siyad23/LFR/Circuit Design/PCBDesign/ReferenceFiles/H-Bridge-Motor-Driver-Circuit-L293D.png

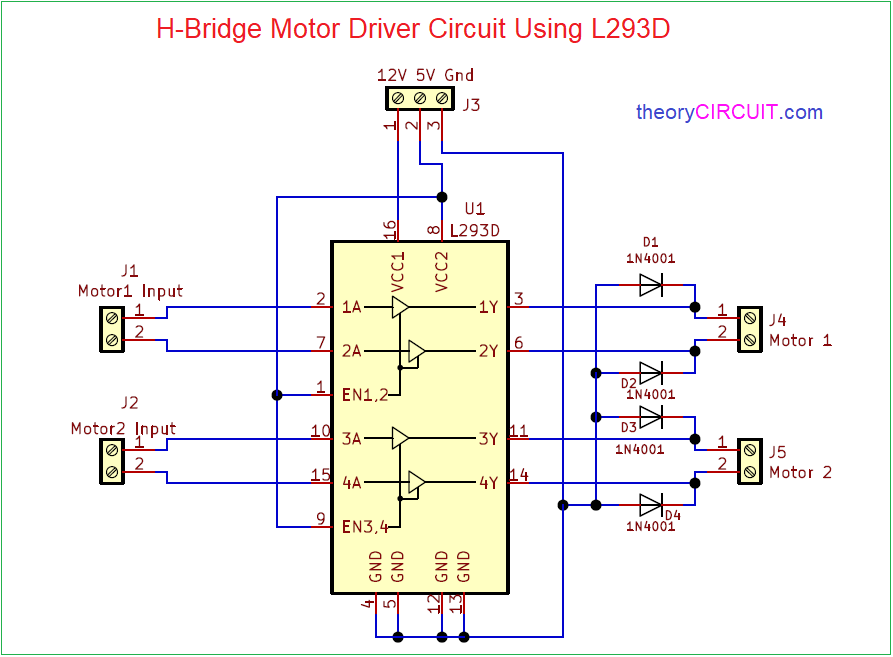
Circuit Design/PCBDesign/ReferenceFiles/H-Bridge-Motor-Driver-Circuit-L293D.png
