siyad23/LFR/MechanicalDesign/Enclosure/EnclosureDraft.JPG

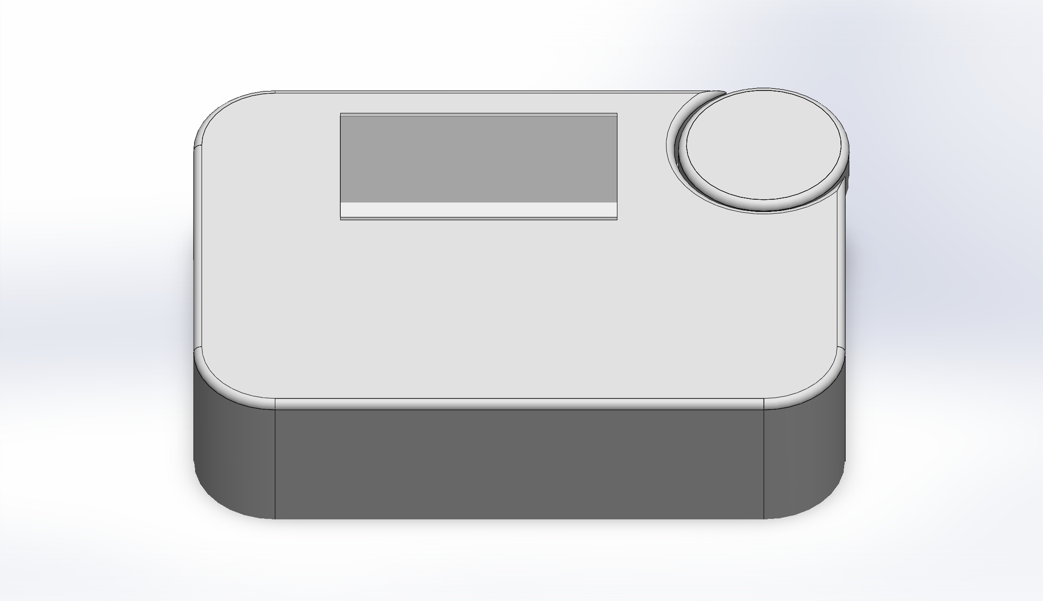
MechanicalDesign/Enclosure/EnclosureDraft.JPG
