siyad23/LFR/MechanicalDesign/mainBody.SLDPRT

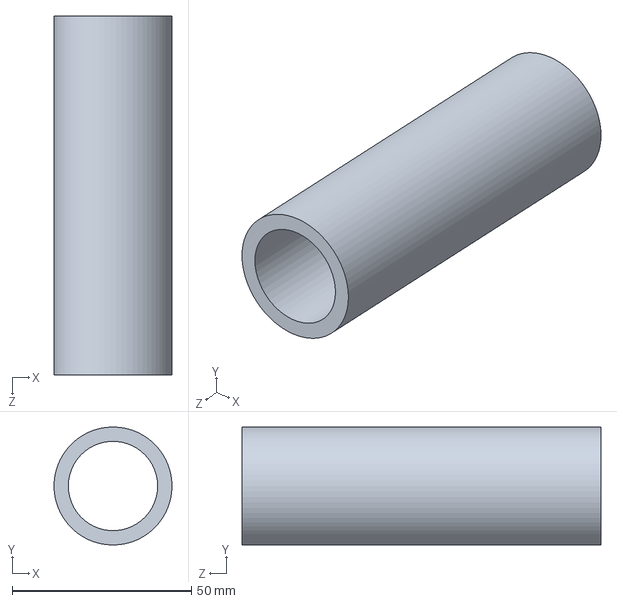
[picture p4: CAD file, 2025-07-23]
MechanicalDesign/mainBody.SLDPRT
32.9 x 32.9 x 100.0 mm
