siyad23/LFR/Chassis Design/Step Files/Sonar setup.STEP

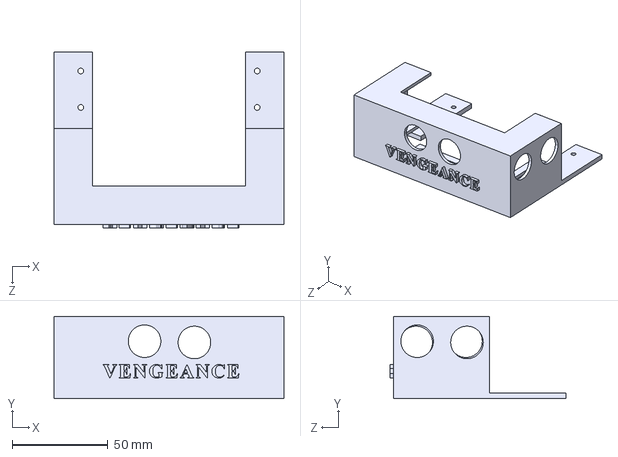
[picture p5: CAD file, 2025-07-26]
Chassis Design/Step Files/Sonar setup.STEP
120.0 x 43.0 x 92.0 mm
