siyad23/LFR/MechanicalDesign/Enclosure/EnclosureDraft.SLDPRT

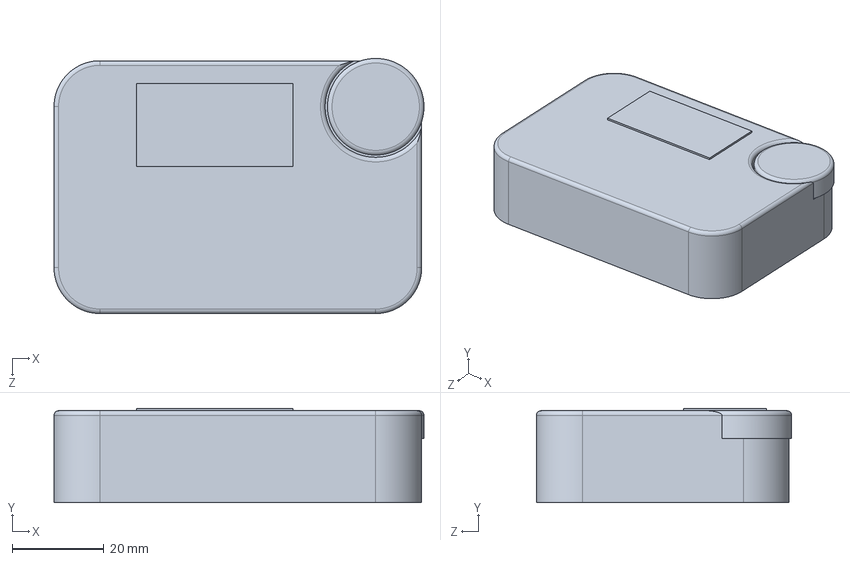
[picture p6: CAD file, 2025-07-05]
MechanicalDesign/Enclosure/EnclosureDraft.SLDPRT
80.5 x 20.5 x 55.5 mm
