siyad23/LFR/Chassis Design/Step Files/Motor Hub.STEP

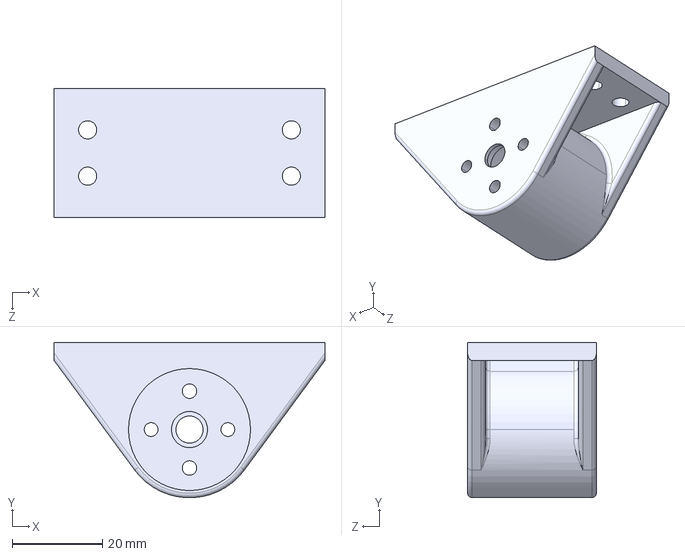
[picture p7: CAD file, 2025-07-26]
Chassis Design/Step Files/Motor Hub.STEP
60.0 x 34.4 x 28.5 mm
