siyad23/LFR/MechanicalDesign/Motor.SLDPRT

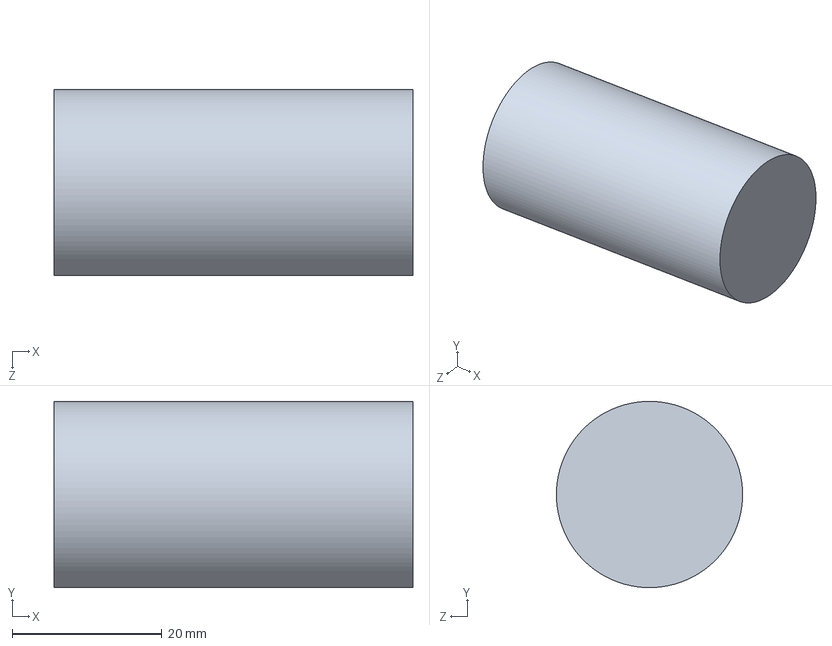
[picture p8: CAD file, 2025-07-23]
MechanicalDesign/Motor.SLDPRT
48.0 x 24.9 x 24.9 mm
