siyad23/LFR/Chassis Design/Step Files/LFR Body.STEP

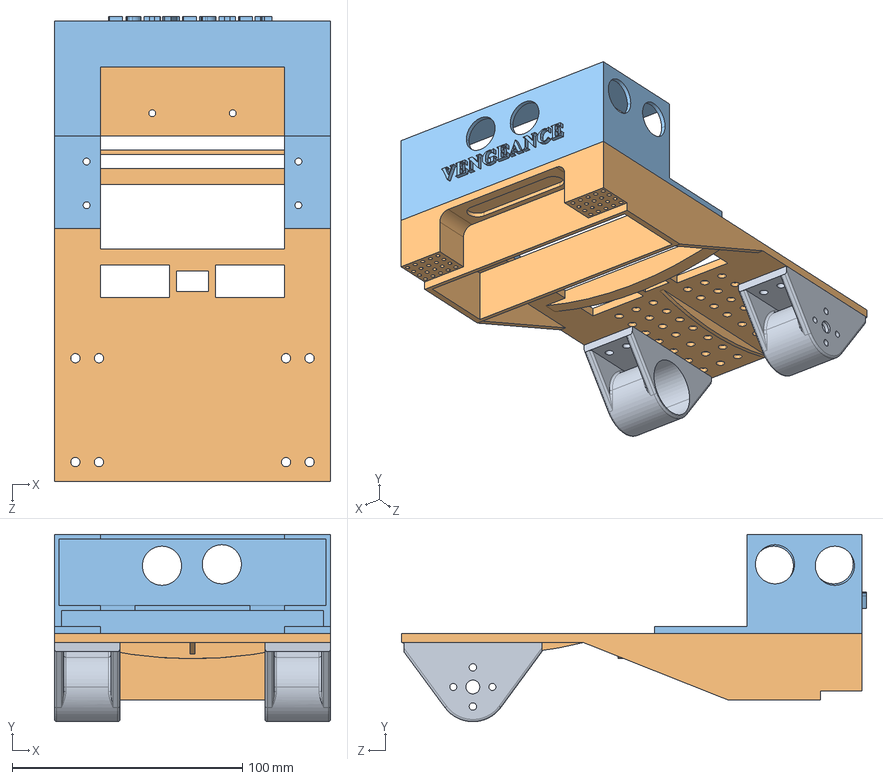
[picture p9: CAD file, 2025-07-26]
Chassis Design/Step Files/LFR Body.STEP
120.0 x 81.4 x 202.0 mm
Motor Hub x 2
Chassis
Sonar setup
