siyad23/LFR/Chassis Design/Step Files/Chassis.STEP

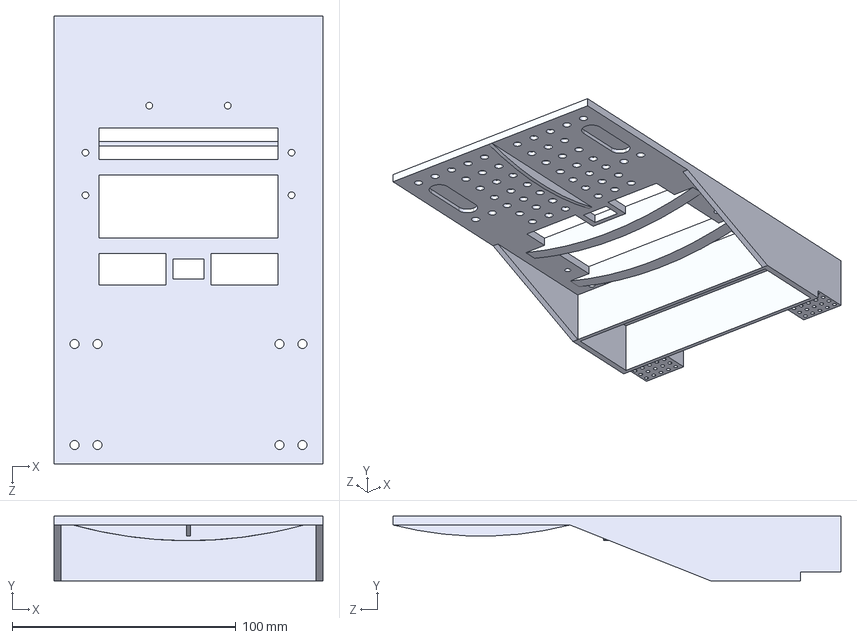
[picture p10: CAD file, 2025-07-26]
Chassis Design/Step Files/Chassis.STEP
120.0 x 29.0 x 200.0 mm
