siyad23/LFR/(list of files, cad)

Other CAD files:
Chassis Design/STL Files/LFR Body - Sonar setup.STL
Chassis Design/SolidWorks Files/Chassis.SLDPRT
Chassis Design/SolidWorks Files/LFR Body.SLDASM
Chassis Design/SolidWorks Files/Motor Hub.SLDPRT
Chassis Design/SolidWorks Files/Sonar setup.SLDPRT
