siyad23/LFR/Circuit Design/VeroBoard Design/print.pdf

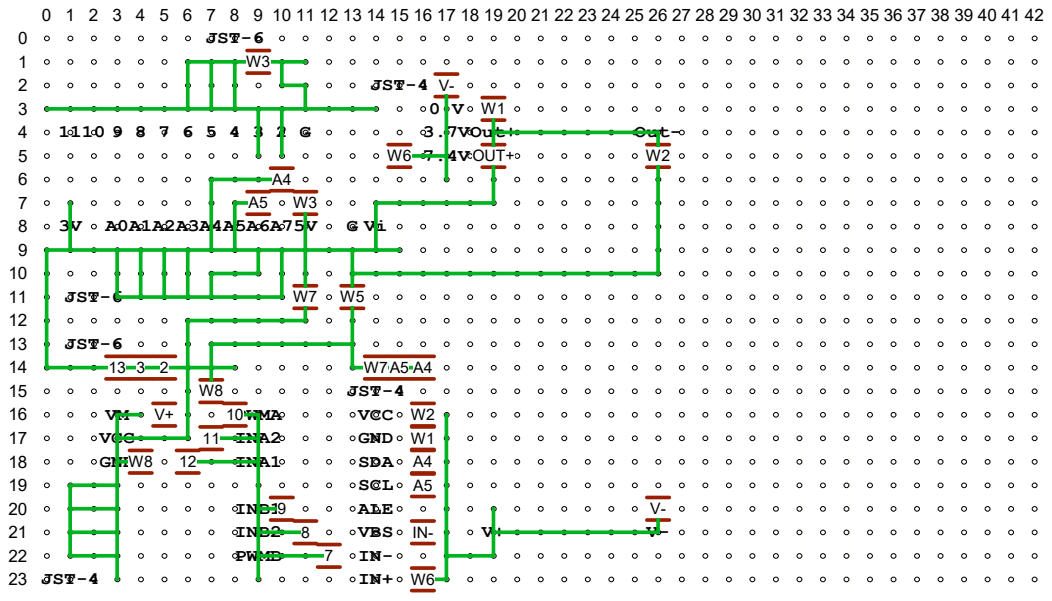
[picture p13: page 1]
GND; JST-4; VCC; JST-6; INA2; PWMA; INA1; INB1 INB2 PWMB; Out+; Out-; VCC GND SDA SCL ALE VBS IN- IN+; OUT+

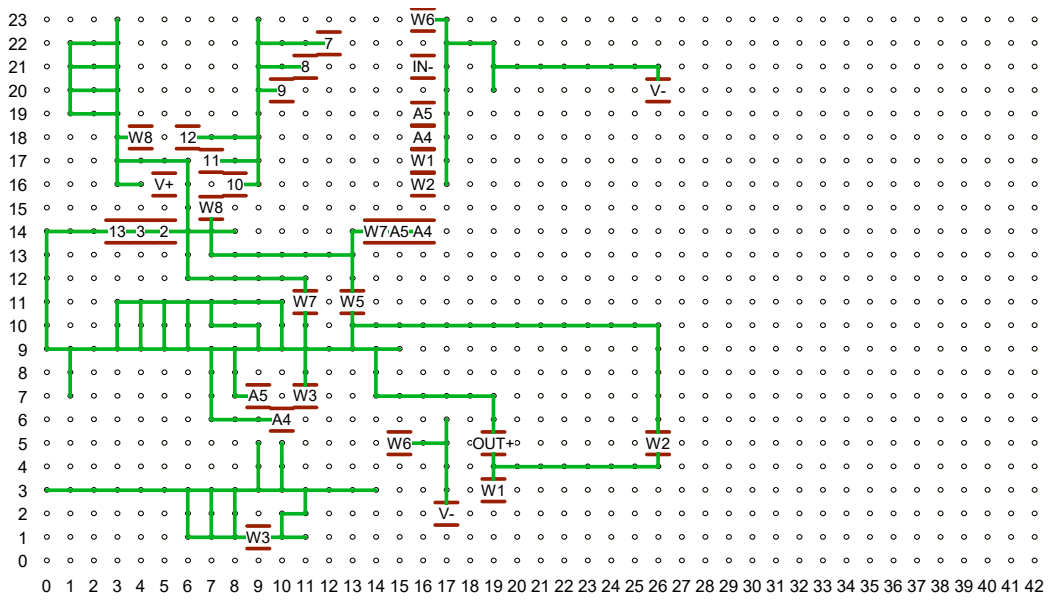
[picture p14: page 2]
OUT+
