siyad23/LFR/Circuit Design/VeroBoard Design/RearView.pdf

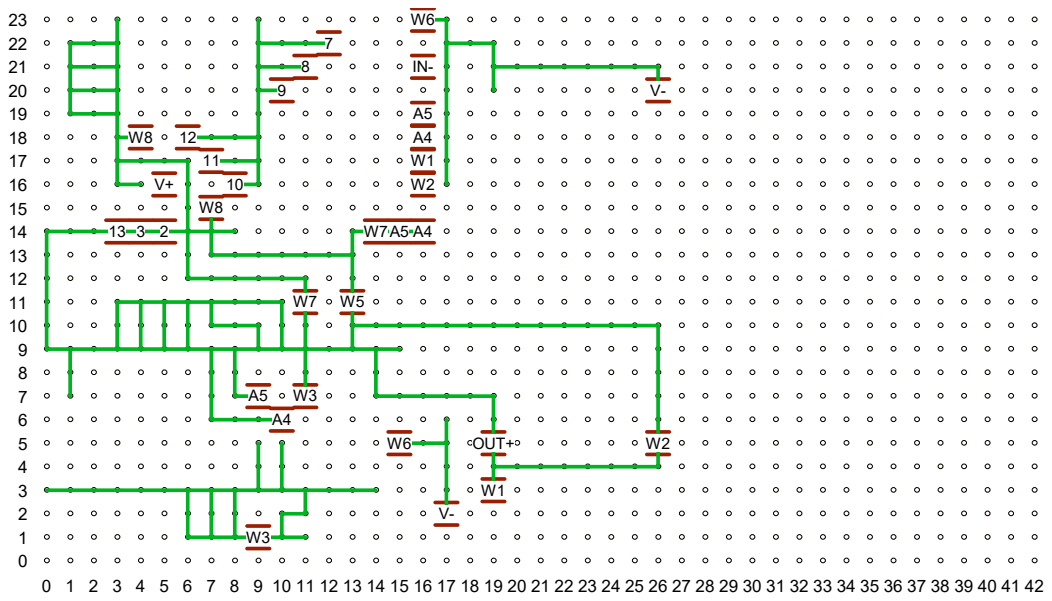
[picture p15: page 1]
OUT+

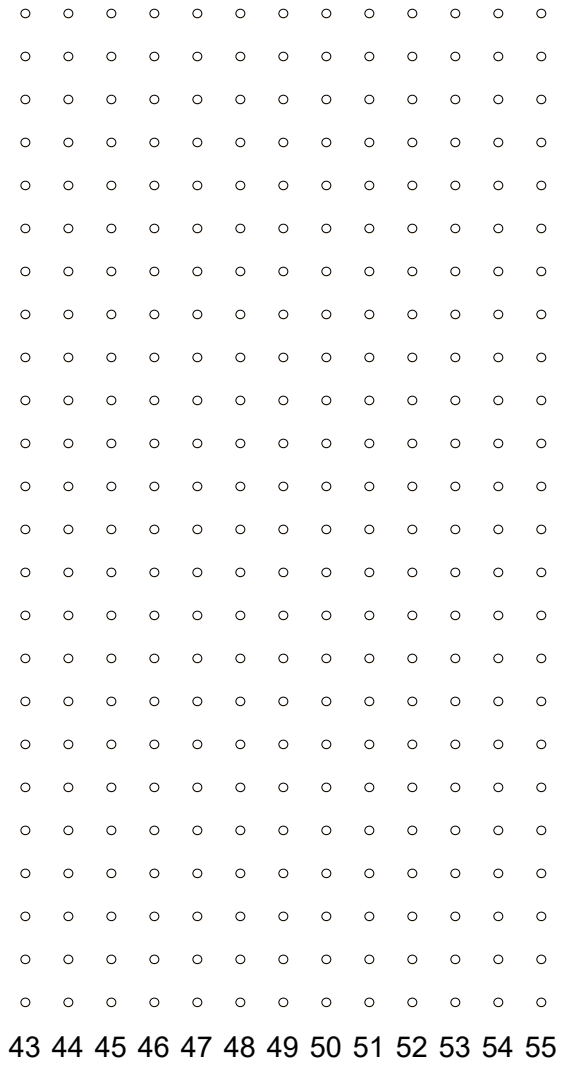
[picture p16: page 2]
