siyad23/LFR/Circuit Design/PCBDesign/LFRCircuit/LFR_Circuit_PDF/LFRCircuit-B_Cu.pdf

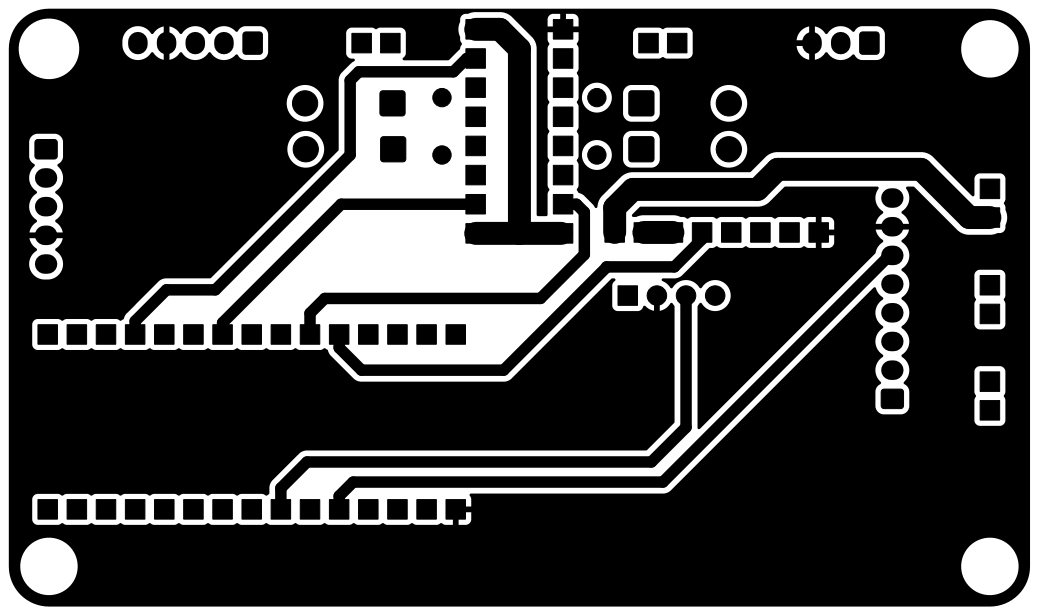
[picture p17: page 1]
