siyad23/LFR/Circuit Design/PCBDesign/LFRCircuit/LFR_Circuit_PDF/LFRCircuit-B_Mask.pdf

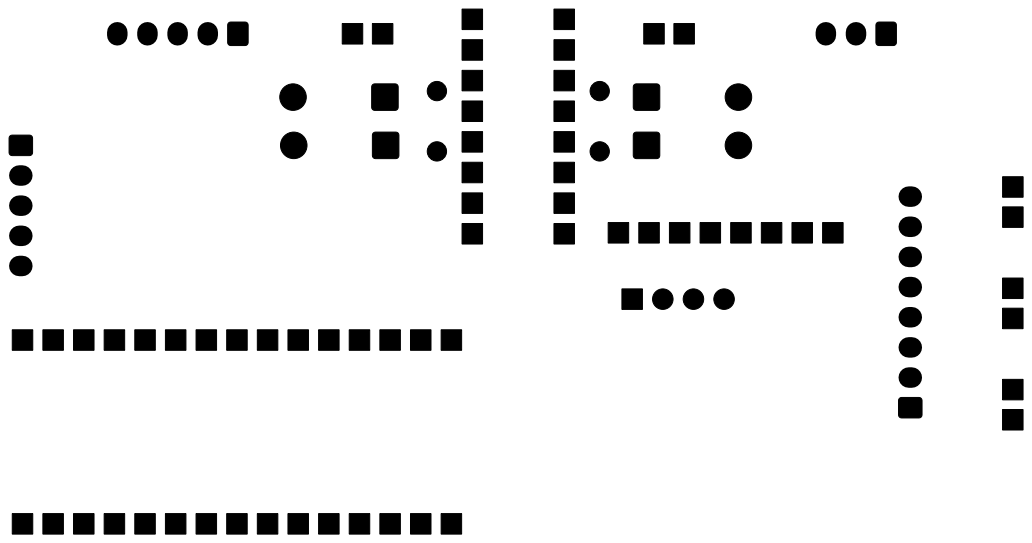
[picture p18: page 1]
