siyad23/LFR/Circuit Design/PCBDesign/LFRCircuit/LFR_Circuit_PDF/LFRCircuit-Edge_Cuts.pdf

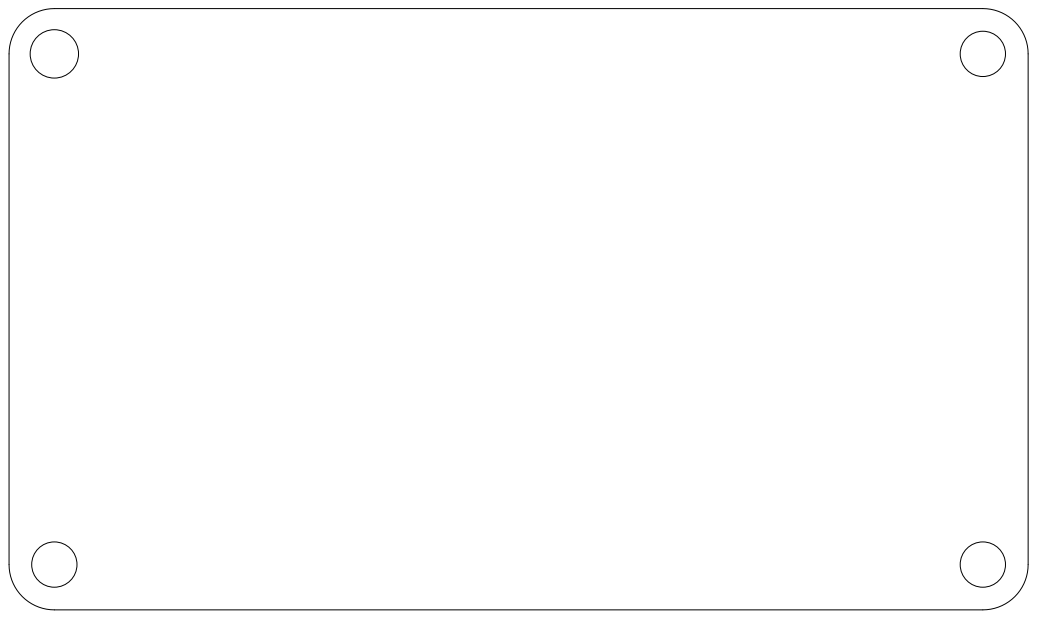
[picture p19: page 1]
