siyad23/LFR/Circuit Design/PCBDesign/LFRCircuit/LFR_Circuit_PDF/LFRCircuit-F_Cu.pdf

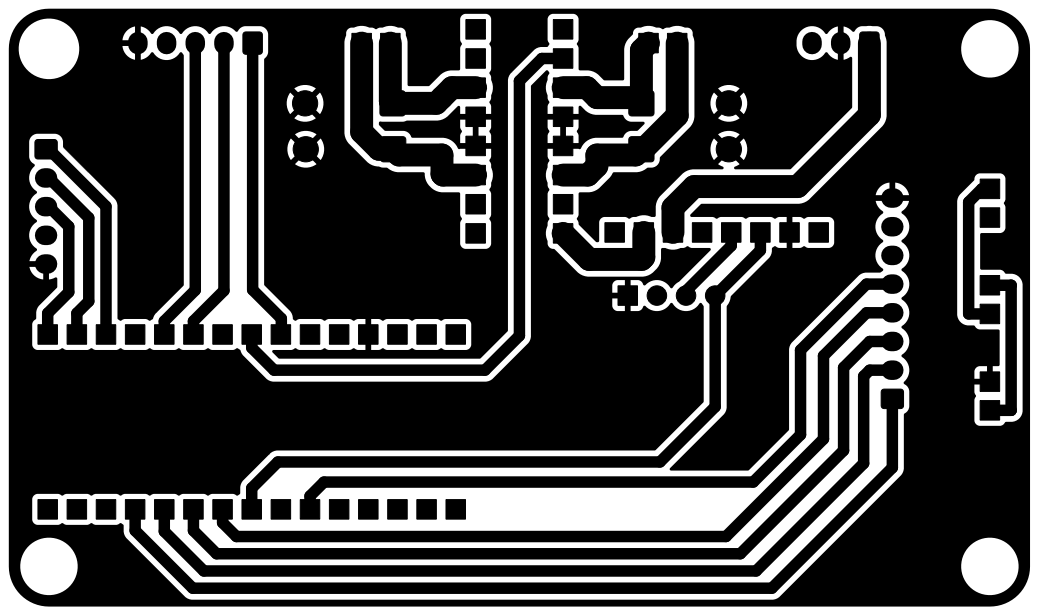
[picture p20: page 1]
