siyad23/LFR/Circuit Design/PCBDesign/LFRCircuit/LFR_Circuit_PDF/LFRCircuit-F_Silkscreen.pdf

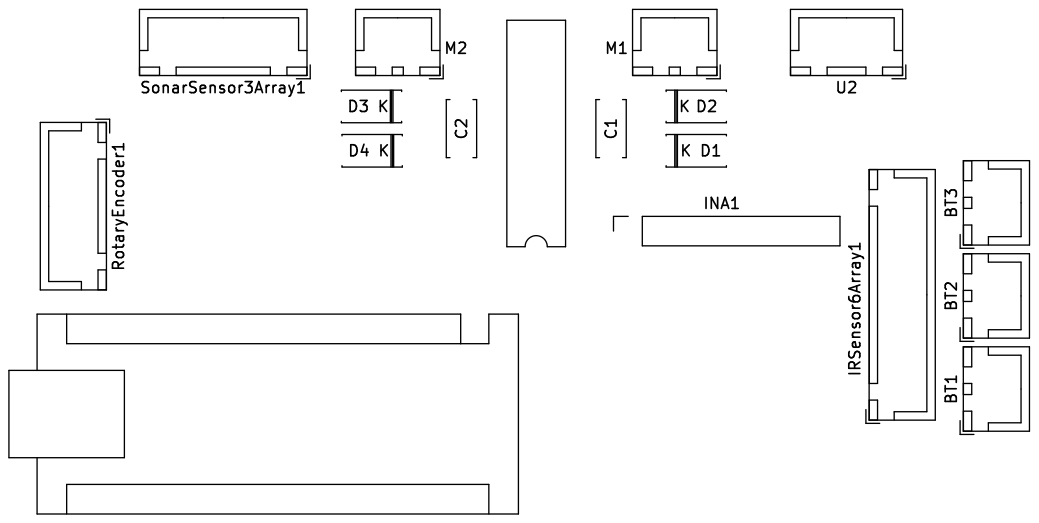
[picture p21: page 1]
