siyad23/LFR/Circuit Design/PCBDesign/LFRCircuit/LFRCircuit.kicad_pcb

## KiCad design Circuit Design/PCBDesign/LFRCircuit/LFRCircuit.kicad_pcb (2025-07-26)

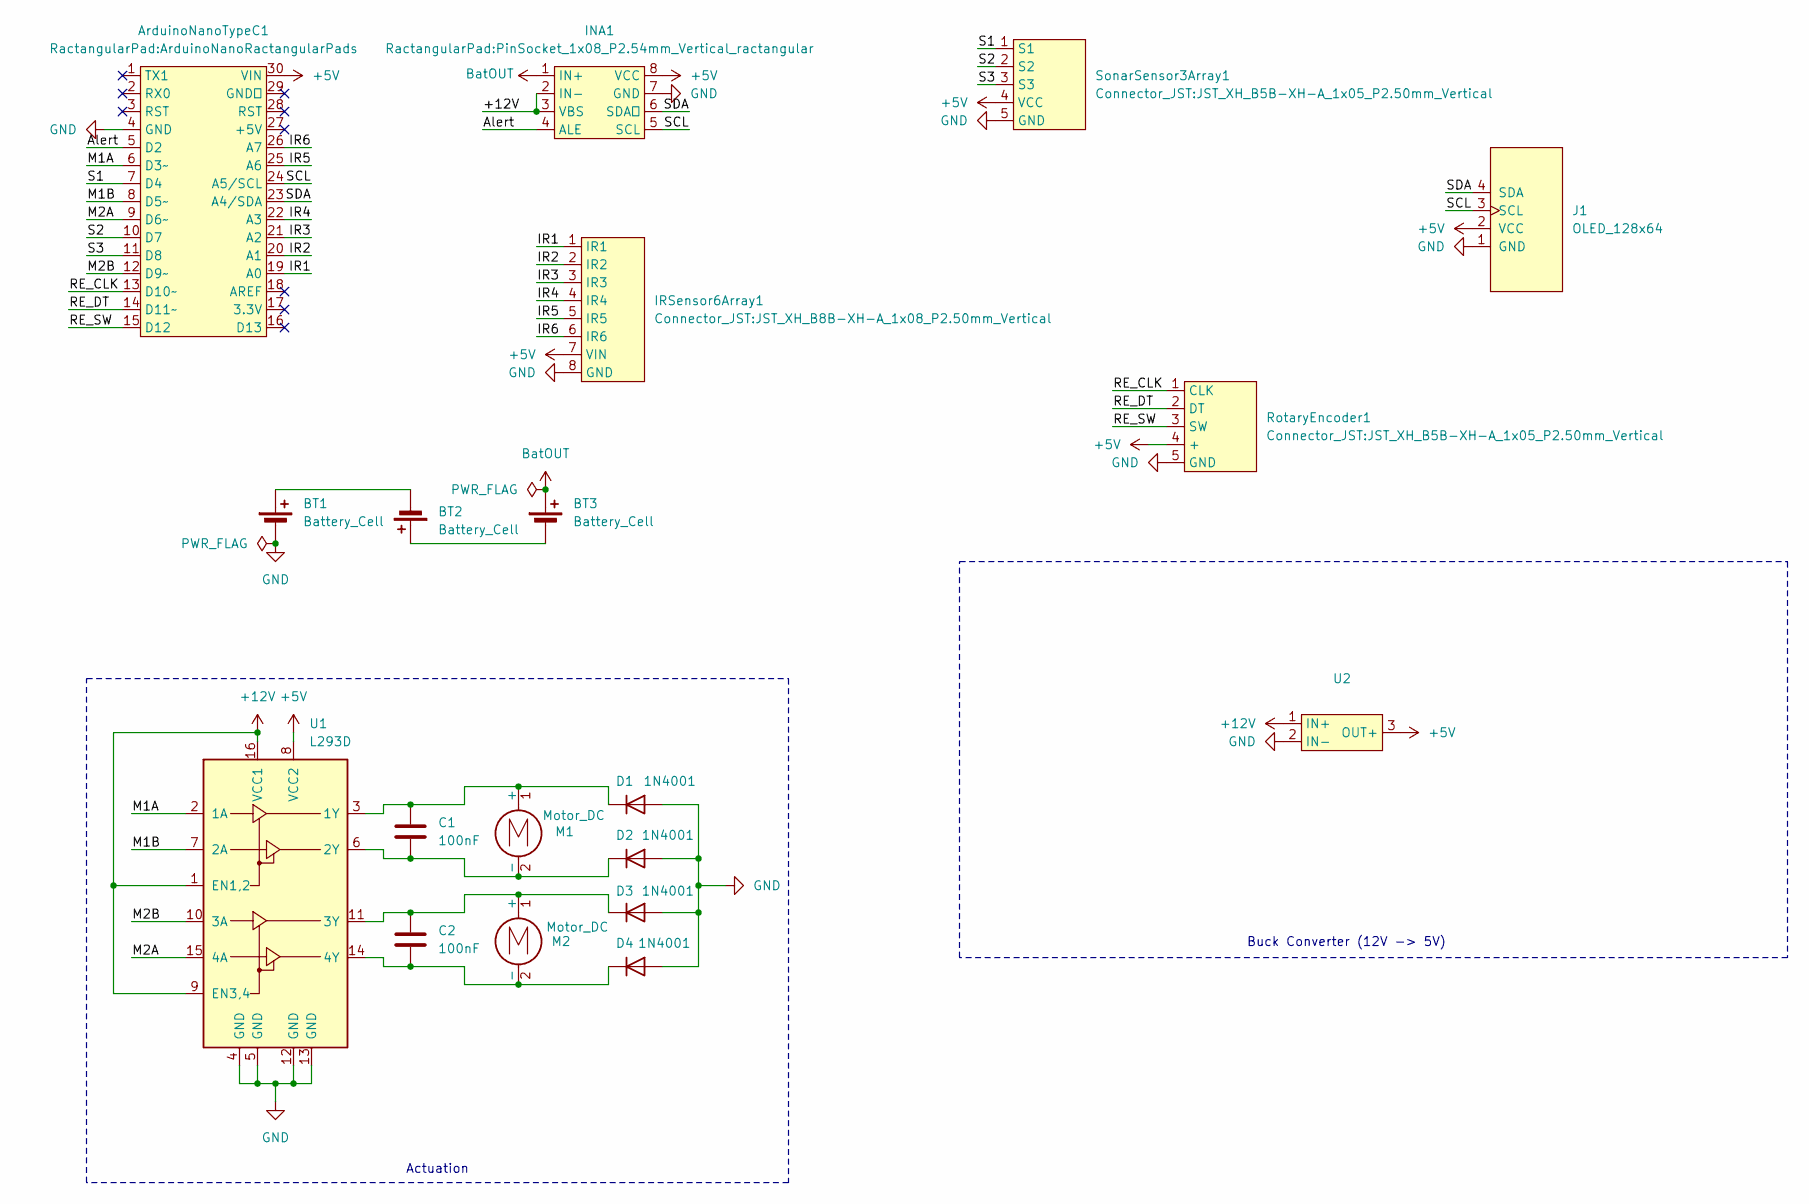
[picture p22: schematic LFRCircuit.kicad_sch, LFR_PCB]

Parts:
ArduinoNanoTypeC1: ArduinoNanoRactangularPads
BT1, BT2, BT3: Battery_Cell; JST_XH_B2B-XH-A_1x02_P2.50mm_Vertical_ractangular
C1, C2: 100nF; C_Disc_D5.0mm_W2.5mm_P5.00mm
D1, D2, D3, D4: 1N4001; D_DO-41_SOD81_P7.62mm_Horizontal
INA1: PinSocket_1x08_P2.54mm_Vertical_ractangular
IRSensor6Array1: JST_XH_B8B-XH-A_1x08_P2.50mm_Vertical
J1: OLED_128x64
M1, M2: Motor_DC; JST_XH_B2B-XH-A_1x02_P2.50mm_Vertical_ractangular
RotaryEncoder1: JST_XH_B5B-XH-A_1x05_P2.50mm_Vertical
SonarSensor3Array1: JST_XH_B5B-XH-A_1x05_P2.50mm_Vertical
U1: L293D; DIP-16_W7.62mm_ractangularPads
U2: JST_XH_B3B-XH-A_1x03_P2.50mm_Vertical

Connections:
+5V: ArduinoNanoTypeC1.30 (VIN), INA1.8 (VCC), IRSensor6Array1.7 (VIN), J1.2 (VCC), RotaryEncoder1.4 (+), SonarSensor3Array1.4 (VCC), U1.8 (VCC2), U2.3 (OUT+)
+12V: INA1.2 (IN-), INA1.3 (VBS), U1.1 (EN1,2), U1.9 (EN3,4), U1.16 (VCC1), U2.1 (IN+)
/Alert: ArduinoNanoTypeC1.5 (D2), INA1.4 (ALE)
/IR1: ArduinoNanoTypeC1.19 (A0), IRSensor6Array1.1 (IR1)
/IR2: ArduinoNanoTypeC1.20 (A1), IRSensor6Array1.2 (IR2)
/IR3: ArduinoNanoTypeC1.21 (A2), IRSensor6Array1.3 (IR3)
/IR4: ArduinoNanoTypeC1.22 (A3), IRSensor6Array1.4 (IR4)
/IR5: ArduinoNanoTypeC1.25 (A6), IRSensor6Array1.5 (IR5)
/IR6: ArduinoNanoTypeC1.26 (A7), IRSensor6Array1.6 (IR6)
/M1A: ArduinoNanoTypeC1.6 (D3~), U1.2 (1A)
/M1B: ArduinoNanoTypeC1.8 (D5~), U1.7 (2A)
/M2A: ArduinoNanoTypeC1.9 (D6~), U1.15 (4A)
/M2B: ArduinoNanoTypeC1.12 (D9~), U1.10 (3A)
/RE_CLK: ArduinoNanoTypeC1.13 (D10~), RotaryEncoder1.1 (CLK)
/RE_DT: ArduinoNanoTypeC1.14 (D11~), RotaryEncoder1.2 (DT)
/RE_SW: ArduinoNanoTypeC1.15 (D12), RotaryEncoder1.3 (SW)
/S1: ArduinoNanoTypeC1.7 (D4), SonarSensor3Array1.1 (S1)
/S2: ArduinoNanoTypeC1.10 (D7), SonarSensor3Array1.2 (S2)
/S3: ArduinoNanoTypeC1.11 (D8), SonarSensor3Array1.3 (S3)
/SCL: ArduinoNanoTypeC1.24 (A5/SCL), INA1.5 (SCL), J1.3 (SCL)
/SDA: ArduinoNanoTypeC1.23 (A4/SDA), INA1.6 (SDA), J1.4 (SDA)
BatOUT: BT3.1 (+), INA1.1 (IN+)
GND: ArduinoNanoTypeC1.4 (GND), BT1.2 (-), D1.2 (A), D2.2 (A), D3.2 (A), D4.2 (A), INA1.7 (GND), IRSensor6Array1.8 (GND), J1.1 (GND), RotaryEncoder1.5 (GND), SonarSensor3Array1.5 (GND), U1.4 (GND), U1.5 (GND), U1.12 (GND), U1.13 (GND), U2.2 (IN-)
unnamed: BT1.1 (+), BT2.2 (-)
unnamed: BT2.1 (+), BT3.2 (-)
unnamed: C1.1, D1.1 (K), M1.1 (+), U1.3 (1Y)
unnamed: C1.2, D2.1 (K), M1.2 (-), U1.6 (2Y)
unnamed: C2.1, D3.1 (K), M2.1 (+), U1.11 (3Y)
unnamed: C2.2, D4.1 (K), M2.2 (-), U1.14 (4Y)

Notes on the sheet:
Actuation
Buck Converter (12V -> 5V)

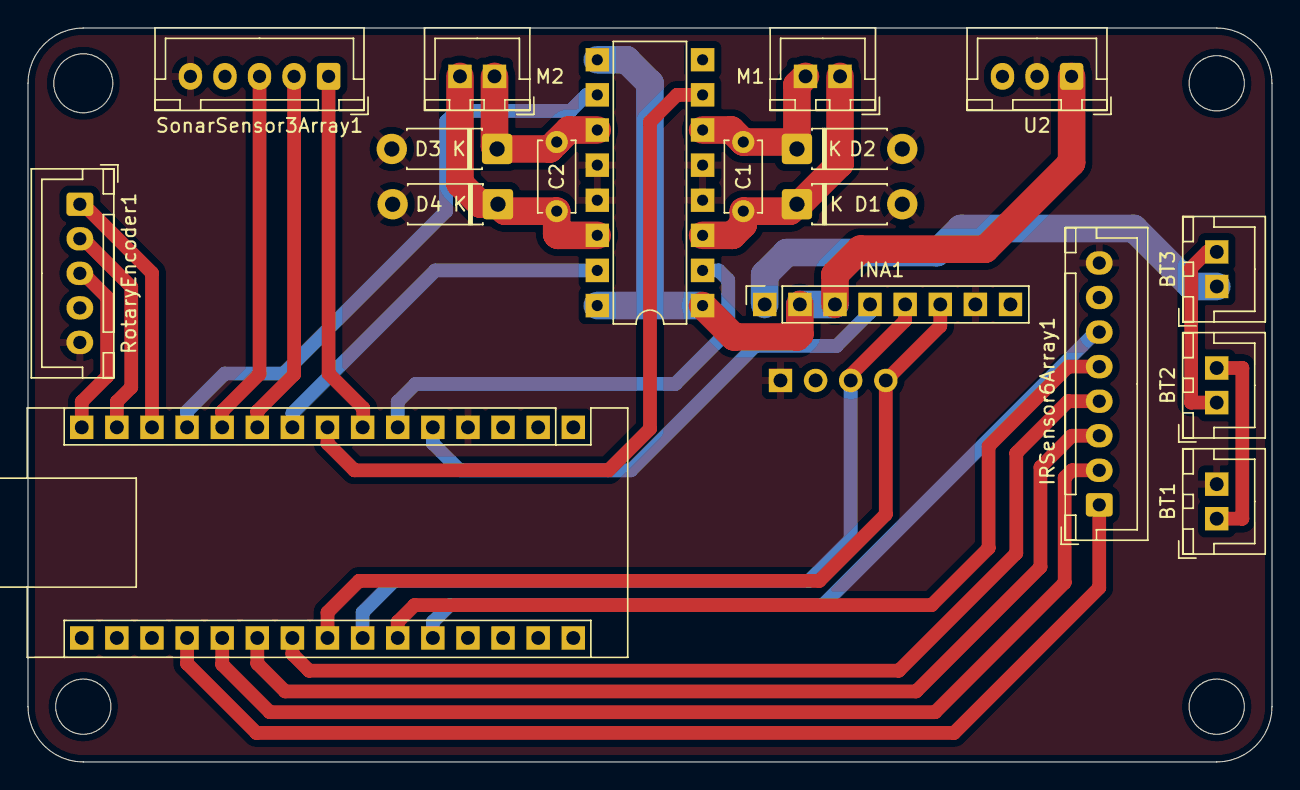
[picture p23: board LFRCircuit.kicad_pcb from above]

Board: 2 copper layers, 90.0 x 53.1 mm, 19 parts (0 on the bottom side), 29 nets.
