siyad23/LFR/Code/src/logo.h

typedef struct logo_t
{
    const unsigned char *logo_bit; // Pointer to the bitmap data
    int width;
    int height;
} logo_t;

// Array of logo_t structures

static const unsigned char PROGMEM calibrate_bits[] = {0x31, 0x8c, 0x31, 0x8c, 0x31, 0x8c, 0x31, 0x8c, 0x31, 0x8c, 0x31, 0x8c, 0x31, 0x8c, 0x31, 0x8c, 0x31, 0x8c, 0x31, 0x8c, 0x31, 0x8c, 0x31, 0x8c, 0x31, 0x8c, 0x31, 0x8c, 0x31, 0x8c, 0x31, 0x8c};

logo_t calibrate_logo = {
    calibrate_bits, 16, 16};

static const unsigned char PROGMEM speed_bits[] = {0x07, 0xc0, 0x19, 0x30, 0x29, 0x28, 0x40, 0x04, 0x60, 0x0c, 0x80, 0x02, 0x80, 0x02, 0xe1, 0x0e, 0x80, 0x02, 0x80, 0x02, 0x60, 0x0c, 0x40, 0x04, 0x29, 0x28, 0x19, 0x30, 0x07, 0xc0, 0x00, 0x00};

logo_t speed_logo = {
    speed_bits, 15, 16};

static const unsigned char PROGMEM DMP_bits[] = {0x30, 0x0c, 0x48, 0x12, 0x48, 0x12, 0x30, 0x0c, 0x08, 0x10, 0x08, 0x10, 0x04, 0x20, 0x04, 0x20, 0x02, 0x40, 0x02, 0x40, 0x01, 0x80, 0x02, 0x40, 0x02, 0x40, 0x01, 0x80};

logo_t DMP_logo = {
    DMP_bits, 16, 14};
