siyad23/LFR/(commit log)

2025-07-05 Something New
    [EnclosureDraft.SLDPRT]
2025-07-05 PCB Schematic is partially Done
    [EnclosureDraft.SLDPRT, LFRCircuit.kicad_pcb, LFRCircuit.kicad_sch]
2025-07-05 Added Rotary Encoder and OLED Display Schematic
    [LFRCircuit.kicad_sch]
2025-07-07 Finalized the Schematics
    [LFRCircuit.kicad_sch]
2025-07-07 Placed on the PCB
    [LFRCircuit.kicad_pcb, LFRCircuit.kicad_sch, freerouting.dsn]
2025-07-23 Circuit design is completed
    [LFRCircuit-B_Cu.gbr, LFRCircuit-B_Mask.gbr, LFRCircuit-B_Paste.gbr, LFRCircuit-B_Silkscreen.gbr, LFRCircuit-Edge_Cuts.gbr, LFRCircuit-F_Cu.gbr, LFRCircuit-F_Mask.gbr, LFRCircuit-F_Paste.gbr]
2025-07-23 Tweaked a little bit
    [LFRCircuit-B_Cu.gbr, LFRCircuit-B_Mask.gbr, LFRCircuit-B_Paste.gbr, LFRCircuit-B_Silkscreen.gbr, LFRCircuit-Edge_Cuts.gbr, LFRCircuit-F_Cu.gbr, LFRCircuit-F_Mask.gbr, LFRCircuit-F_Paste.gbr]
2025-07-26 Updated PCB
    [LFRCircuit.kicad_pcb, LFRCircuit.kicad_sch]
2025-07-26 Added chassis design files
    [Chassis.SLDPRT, Chassis.STEP, LFR Body - Sonar setup.STL, LFR Body.SLDASM, LFR Body.STEP, Motor Hub.SLDPRT, Motor Hub.STEP, Sonar setup.SLDPRT]
